kiki348/codex-micro-diy/hardware/gerber/STATUS.md

# 制板文件核对状态

2026-10-13 已核对当前工程、下载目录和旧工程归档。找到的 Gerber 压缩包属于早期 STM32 RevA 或其他上游参考项目，不能与 ESP32-S3 `.18` 固件配套。
当前可用源文件为上级目录的 2026-08-10 EPRO2 工程。可在嘉立创 EDA 中直接打开对应控制板和键轴板导出制板文件。
网页编辑器的控制板检查最终显示一项网表不一致，尚需核对。当前目录不提供冒充已核查版本的旧 Gerber，也不宣称制造包已经完成验收。
