kiki348/codex-micro-diy/THIRD_PARTY_NOTICES.md

# 来源、许可与归属

| 内容 | 来源 | 处理 |
|---|---|---|
| 原理图/PCB/原作者机构 | [wlk6655工程](https://oshwhub.com/wlk6655/project_arhgqemg) | 当前页面BSD-2-Clause；保留署名及完整许可正文 |
| 上游固件 | [wanglinkai326仓库](https://github.com/wanglinkai326/led-control-system-firmware) | 保留来源与文件版权头；MIT头为imliubo署名，不改变权利人 |
| 本地固件适配/教程/发布脚本 | 本仓库 | 新增贡献MIT；不把上游全体文件改标为本项目原创 |
| Arduino-ESP32/ESP-IDF启动文件 | Espressif | 按构建框架原许可分发，发行包附许可目录 |
| WorkAxis运行包 | 基于官方Input的修改版 | 闭源运行包，保留Electron/Chromium和依赖许可 |
| 实物照片 | 本DIY键盘实拍 | 真实产品照片；封面辅助图形为示意 |

原工程作者正文允许个人制作与分发改进，并列出固件源码链接；平台统一页脚有商业性使用限制。本项目不出售资料、不据此对第三方商标/商业权利另作授权。维护者于2026-10-13确认此前已取得本项目开发与公开再分发许可；该确认不替代原文件许可证，也不将缺失许可头补写成作者从未签署的声明。

固件仓库根目录没有完整LICENSE，部分文件有SPDX MIT。本仓库明确保留这一许可记录缺口，复用上游部分时同时查看原作者工程声明与各文件版权头；本地新增MIT许可不扩大第三方授权范围。

Codex、Input、Work Louder等名称用于说明兼容对象，归各自权利人所有。本DIY项目无官方合作或认证声明。
