kiki348/codex-micro-diy/docs/use-cases.md

# Codex Micro 玩法资料与采用记录

核查日期：2026-10-13。优先使用官方原始演示和作者自己的项目说明。

| 来源 | 可核查的玩法 | 视频采用 | 与本机的关系 |
|---|---|---|---|
| [OpenAI 官方演示](https://www.youtube.com/watch?v=m8uUUUsMD3Y) 00:24、01:28、01:49 | 语音提出猜词游戏，排队追加连胜效果，展示游戏结果 | 自绘 COLD→CORD→WORD→WARD→WARM 游戏与追加需求动画 | 原版玩法重绘，不是本机联动录屏 |
| 同一演示 00:45、01:01、01:16 | 旋钮调节思考；按键选择任务；通知和授权 | 旋钮与档位同步、按键与任务同步、确认提示 | 原版玩法动画 |
| 同一演示 01:44、01:59 | 等待时盘摇杆、可配置操作包括触发桌宠 | 摇杆摆动与自绘小桌宠 | 原版提到的用途；桌宠美术为本项目自绘 |
| [OpenAI / Work Louder 产品页](https://openai.com/supply/co-lab/work-louder/) | Agent 状态灯、工作流摇杆、专用操作键、思考旋钮 | 对照演示核查，不把灯光写成 AI 本体 | 原版产品规格不能套给 DIY：原版 13 开关，本机 12 按键 |
| [作者的周末 DIY](https://github.com/Nishkalkashyap/codex-micro-device) | ESP32-S3、手工接线、快捷键、3D 打印；明确未实现原版状态反馈 | 作为复刻路线的研究参考，不复制其结构文件和价格 | 是另一位作者的项目，不能当作我们的实测 |
| [OpenMicro 作者项目](https://github.com/stephenleo/OpenMicro) | 将类似操作映射到游戏手柄；声明不同工具的功能差异 | 用于“AI 手柄”创意判断；没有在片中宣称本机兼容其软件 | 外部工具，与本机不同 |
| [Codex Stream Deck 作者项目](https://github.com/dazer1234/codex-stream-deck) | Windows 上用 Stream Deck 控制 Codex 的非官方桥接 | 说明社区兴趣点是操作体验；不拼接到本机成果 | 外部项目 |

官方英文字幕通过浏览器提供的转写导出功能读取。具体观察：00:29 要求 One Letter Off，逐次改一个字母将 cold 变为 warm；00:52 旋钮控制 reasoning；01:05 固定任务映射到键；01:21 授权请求；01:36 要求更明显的胜利状态和连胜计数；01:44 摇杆可解压；01:59 自定义操作可触发 pet。

## 成片表达约束

5–39 秒持续显示“原版玩法重绘 · 非本机联动实录”。39 秒之后是真实 DIY 照片与制作路线。Windows 配置写入与回读已有核验，但不能据此宣称完整 Codex 联动已实测。当前板的 Gerber 导出仍待完善，不在片中称“Gerber 已全部可用”。不使用其他作者视频画面，不搬运原声或他们的工程。用户提供的配乐用于当前视频，原音频不进入公开仓库。
