kiki348/codex-micro-diy/docs/02-procurement.md

# 采购、价格与店铺

电子元件以 `hardware/bom/control-board.csv` 与 `key-board.csv` 为准：它们从实际 PCB 放置元件提取，排除了原理图电源符号。空白 MPN 是需要核对的项目，不代表随意替代。

| 物品 | 来源链接/规格 | 价格口径 |
|---|---|---|
| 主控 | ESP32-S3-WROOM-1U-N16R8，带天线接口 | 当前版本实付记录未完整恢复 |
| 半高轴 | [上游高特半高轴](https://item.taobao.com/item.htm?id=962160116626) | 上游推荐，非本项目已确认实付 |
| 旋钮编码器 | [上游 EC11](https://item.taobao.com/item.htm?id=532612286066) | 核对实际柄长；上游“15cm”有单位疑点，不能照抄采购 |
| 摇杆 | [PSP 平面 10k 无下压](https://detail.tmall.com/item.htm?id=521302135190&skuId=5927611536413) | 上游推荐，双轴电位器 |
| 排线 | 16pin FPC，原作者装配使用 10cm | 核对两端接点朝向、间距与座子锁扣 |
| 底板螺丝 | M2×8 平头/超薄平头自攻 | 按实际板厚和孔位试装 |
| 面板紧固 | 4 个 M3×3 隔离柱、4 个 M3×14 螺丝、4 个 M3 螺母 | 原作者装配规格 |
| 防滑脚垫 | 1mm 厚 | 原作者装配规格 |
| 电池与天线 | 必须按控制板接口、极性和下壳空间匹配 | 无确认型号时不补编购买链接 |

原附件推荐过“优信电子”等店铺，这是上游建议，不能当作本项目实际购买店铺。CSV 保留实际店铺/实付价格列，尚未找回的内容留空。

## 找回的历史支出

2026-08-03 的旧路线记录：PCB 5片实付3元，EC11 两个17元，KS33 Low Profile 2.0 17个25元，四件首版打印件历史券后货款/运费均0元，合计45元。**这些属于早期 STM32/首版路线，不是当前 ESP32-S3 成品总成本；KS33 也不等于当前高特半高轴。**

同记录中的元件103元、焊接150元是报价，非确认实付。当前项目总价不使用上述数字拼算。每条缺失价格可按公开 BOM 联系商家报价，记录日期、数量、运费与是否代焊。
