kiki348/codex-micro-diy/assets/keyboard-rgb.jpg

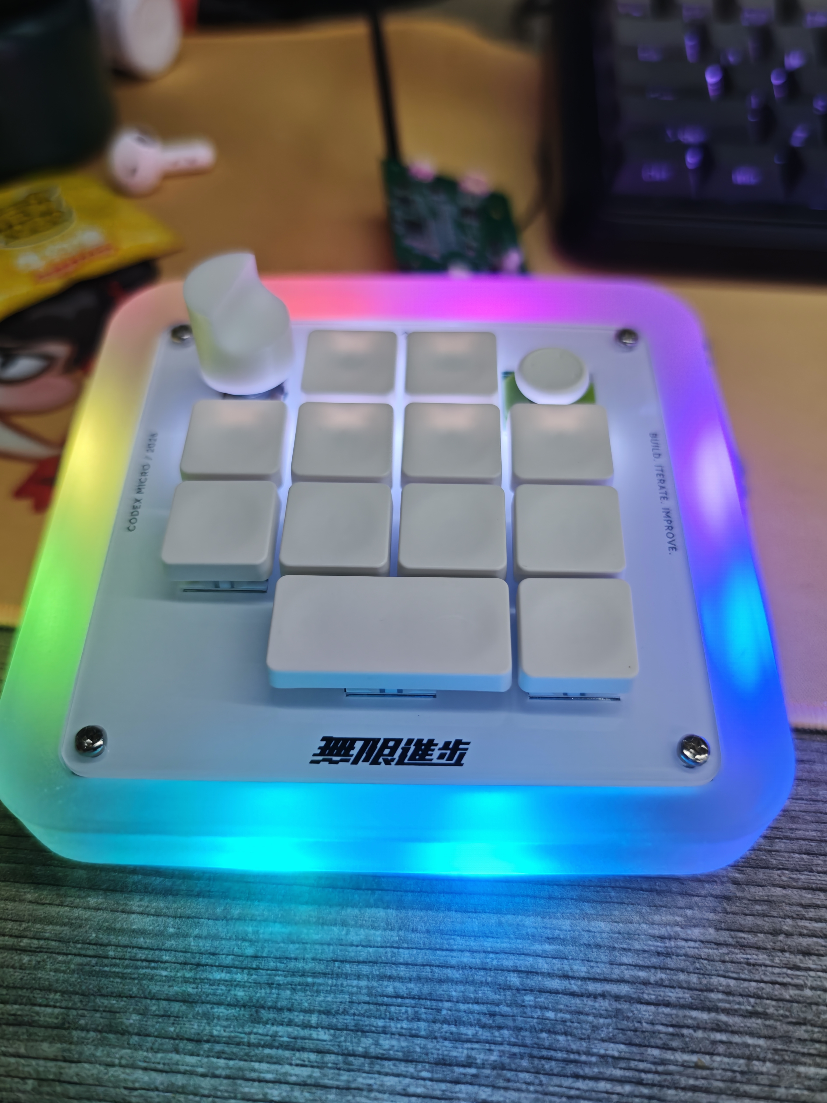
assets/keyboard-rgb.jpg
