kiki348/codex-micro-diy/hardware/bom/control-board.csv

位号 | 数量 | MPN | 制造商 | 值 | 封装 | 商城编号 | 贴装面 | X_mm | Y_mm | 角度 | 实际店铺 | 实际支付元 | 来源 | 核对状态
C1 | 1 | CL10A475KO8NNNC | SAMSUNG(三星) | 4.7uF | C0603 | C19666 | Top | 54.5 | -10.5 | 90 |  |  | 2026-08-10 PCB e43935b56b465ac6 | 源 PCB MPN 已提取；未验证库存/替代料
C17 | 1 | CL10A106KP8NNNC | SAMSUNG(三星) | 10uF | C0603 | C19702 | Top | 67.7 | -34.4 | 0 |  |  | 2026-08-10 PCB e43935b56b465ac6 | 源 PCB MPN 已提取；未验证库存/替代料
C18 | 1 | CL10B104KB8NNNC | SAMSUNG(三星) | 100nF | C0603 | C1591 | Top | 67.7 | -30.1 | 0 |  |  | 2026-08-10 PCB e43935b56b465ac6 | 源 PCB MPN 已提取；未验证库存/替代料
C19 | 1 | CL10B104KB8NNNC | SAMSUNG(三星) | 100nF | C0603 | C1591 | Top | 69.5 | -40.9 | 90 |  |  | 2026-08-10 PCB e43935b56b465ac6 | 源 PCB MPN 已提取；未验证库存/替代料
C2 | 1 | CL10A226MP8NUNE | SAMSUNG(三星) | 22uF | C0603 | C86295 | Top | 66.1 | -14.2 | 180 |  |  | 2026-08-10 PCB e43935b56b465ac6 | 源 PCB MPN 已提取；未验证库存/替代料
C20 | 1 | CL10A106KP8NNNC | SAMSUNG(三星) | 10uF | C0603 | C19702 | Top | 66.9 | -40.9 | 90 |  |  | 2026-08-10 PCB e43935b56b465ac6 | 源 PCB MPN 已提取；未验证库存/替代料
C21 | 1 | CL10A226MP8NUNE | SAMSUNG(三星) | 22uF | C0603 | C86295 | Top | 20.2999 | -20.0 | 0 |  |  | 2026-08-10 PCB e43935b56b465ac6 | 源 PCB MPN 已提取；未验证库存/替代料
C22 | 1 | CL10B104KB8NNNC | SAMSUNG(三星) | 100nF | C0603 | C1591 | Top | 20.2077 | -22.3027 | 0 |  |  | 2026-08-10 PCB e43935b56b465ac6 | 源 PCB MPN 已提取；未验证库存/替代料
C25 | 1 | CL10B104KB8NNNC | SAMSUNG(三星) | 100nF | C0603 | C1591 | Top | 48.5077 | -24.0177 | 180 |  |  | 2026-08-10 PCB e43935b56b465ac6 | 源 PCB MPN 已提取；未验证库存/替代料
C3 | 1 | CL10B104KB8NNNC | SAMSUNG(三星) | 100nF | C0603 | C1591 | Top | 66.1 | -16.5 | 180 |  |  | 2026-08-10 PCB e43935b56b465ac6 | 源 PCB MPN 已提取；未验证库存/替代料
C4 | 1 | CL10A226MP8NUNE | SAMSUNG(三星) | 22uF | C0603 | C86295 | Top | 65.6 | -25.0 | -90 |  |  | 2026-08-10 PCB e43935b56b465ac6 | 源 PCB MPN 已提取；未验证库存/替代料
C5 | 1 | CL10B104KB8NNNC | SAMSUNG(三星) | 100nF | C0603 | C1591 | Top | 63.4 | -25.0 | -90 |  |  | 2026-08-10 PCB e43935b56b465ac6 | 源 PCB MPN 已提取；未验证库存/替代料
C6 | 1 | CL10B104KB8NNNC | SAMSUNG(三星) | 100nF | C0603 | C1591 | Top | 55.8 | -37.2 | 90 |  |  | 2026-08-10 PCB e43935b56b465ac6 | 源 PCB MPN 已提取；未验证库存/替代料
C7 | 1 | CC0603KRX7R9BB102 | YAGEO(国巨) | 1nF | C0603 | C100040 | Top | 18.6 | -34.2 | 90 |  |  | 2026-08-10 PCB e43935b56b465ac6 | 源 PCB MPN 已提取；未验证库存/替代料
C8 | 1 | CGA0603X5R105K500JT | HRE(芯声) | 1uF | C0603 | C6119852 | Top | 26.9 | -40.7 | 0 |  |  | 2026-08-10 PCB e43935b56b465ac6 | 源 PCB MPN 已提取；未验证库存/替代料
D1 | 1 | SS34 | TWGMC(台湾迪嘉) |  | SMA_L4.3-W2.5-LS5.0-RD | C727060 | Top | 60.4 | -24.2 | 90 |  |  | 2026-08-10 PCB e43935b56b465ac6 | 源 PCB MPN 已提取；未验证库存/替代料
D3 | 1 | SS34 | TWGMC(台湾迪嘉) |  | SMA_L4.3-W2.5-LS5.0-RD | C727060 | Top | 71.8 | -28.0 | 90 |  |  | 2026-08-10 PCB e43935b56b465ac6 | 源 PCB MPN 已提取；未验证库存/替代料
FPC1 | 1 | FPC16-T1T1-2020-A | SHETIME(高钺达) |  | FPC-SMD_16P-P0.50_FPC16-T1T1-2020-A | C52740846 | Top | 35.3751 | -45.4161 | 0 |  |  | 2026-08-10 PCB e43935b56b465ac6 | 源 PCB MPN 已提取；未验证库存/替代料
H1 | 1 | 2.54-1x6P直针 | BOOMELE(博穆精密) |  | HDR-TH_6P-P2.54-V-M-1 | C37208 | Top | 54.2 | -31.8 | 0 |  |  | 2026-08-10 PCB e43935b56b465ac6 | 源 PCB MPN 已提取；未验证库存/替代料
J1 | 1 |  |  |  | BAT_2P |  | Top | 62.8 | -10.4 | 0 |  |  | 2026-08-10 PCB e43935b56b465ac6 | 需要核对 MPN
L2 | 1 | SMMS0420-4R7M | SXN(顺翔诺) | 4.7uH | IND-SMD_L4.8-W4.5 | C133193 | Top | 60.8 | -16.9 | -90 |  |  | 2026-08-10 PCB e43935b56b465ac6 | 源 PCB MPN 已提取；未验证库存/替代料
Q1 | 1 | AO3401A | UMW(友台半导体) |  | SOT-23_L2.9-W1.3-P1.90-LS2.4-BR | C347476 | Top | 68.4 | -26.9 | 90 |  |  | 2026-08-10 PCB e43935b56b465ac6 | 源 PCB MPN 已提取；未验证库存/替代料
R1 | 1 | FRC0603J202 TS | FOJAN(富捷) | 2kΩ | R0603 | C2907137 | Top | 54.5 | -14.3 | 90 |  |  | 2026-08-10 PCB e43935b56b465ac6 | 源 PCB MPN 已提取；未验证库存/替代料
R12 | 1 | 0603WAF5101T5E | UNI-ROYAL(厚声) | 5.1kΩ | R0603 | C23186 | Top | 48.1861 | -10.4502 | 90 |  |  | 2026-08-10 PCB e43935b56b465ac6 | 源 PCB MPN 已提取；未验证库存/替代料
R14 | 1 | FRC0603J103 TS | FOJAN(富捷) | 10kΩ | R0603 | C2930027 | Top | 70.6 | -23.0 | -90 |  |  | 2026-08-10 PCB e43935b56b465ac6 | 源 PCB MPN 已提取；未验证库存/替代料
R17 | 1 | FRC0603J103 TS | FOJAN(富捷) | 10kΩ | R0603 | C2930027 | Top | 24.1051 | -18.1 | 0 |  |  | 2026-08-10 PCB e43935b56b465ac6 | 源 PCB MPN 已提取；未验证库存/替代料
R2 | 1 | FRC0603J104 TS | FOJAN(富捷) | 100kΩ | R0603 | C2907088 | Top | 48.6 | -29.2 | 0 |  |  | 2026-08-10 PCB e43935b56b465ac6 | 源 PCB MPN 已提取；未验证库存/替代料
R20 | 1 | FRC0603J104 TS | FOJAN(富捷) | 100kΩ | R0603 | C2907088 | Top | 48.6 | -26.7 | 0 |  |  | 2026-08-10 PCB e43935b56b465ac6 | 源 PCB MPN 已提取；未验证库存/替代料
R3 | 1 | FRC0603J103 TS | FOJAN(富捷) | 10kΩ | R0603 | C2930027 | Top | 49.3 | -15.0 | 180 |  |  | 2026-08-10 PCB e43935b56b465ac6 | 源 PCB MPN 已提取；未验证库存/替代料
R4 | 1 | FRC0603J103 TS | FOJAN(富捷) | 10kΩ | R0603 | C2930027 | Top | 49.3 | -17.6 | 180 |  |  | 2026-08-10 PCB e43935b56b465ac6 | 源 PCB MPN 已提取；未验证库存/替代料
R5 | 1 | FRC0603J104 TS | FOJAN(富捷) | 100kΩ | R0603 | C2907088 | Top | 40.5 | -36.3 | 0 |  |  | 2026-08-10 PCB e43935b56b465ac6 | 源 PCB MPN 已提取；未验证库存/替代料
R6 | 1 | FRC0603F1502TS | FOJAN(富捷) | 15kΩ | R0603 | C2906995 | Top | 67.5 | -19.4 | -90 |  |  | 2026-08-10 PCB e43935b56b465ac6 | 源 PCB MPN 已提取；未验证库存/替代料
R7 | 1 | FRC0603F1001TS | FOJAN(富捷) | 1kΩ | R0603 | C2907002 | Top | 17.0 | -39.0 | 270 |  |  | 2026-08-10 PCB e43935b56b465ac6 | 源 PCB MPN 已提取；未验证库存/替代料
R8 | 1 | FRC0603F1103TS | FOJAN(富捷) | 110kΩ | R0603 | C2906984 | Top | 67.5 | -22.6 | -90 |  |  | 2026-08-10 PCB e43935b56b465ac6 | 源 PCB MPN 已提取；未验证库存/替代料
R9 | 1 | 0603WAF5101T5E | UNI-ROYAL(厚声) | 5.1kΩ | R0603 | C23186 | Top | 51.783 | -10.4852 | 90 |  |  | 2026-08-10 PCB e43935b56b465ac6 | 源 PCB MPN 已提取；未验证库存/替代料
U1 | 1 | MT3608B | 西安航天民芯 |  | SOT-23-6_L2.9-W1.6-P0.95-LS2.8-BR | C19189893 | Top | 64.6 | -20.2 | -90 |  |  | 2026-08-10 PCB e43935b56b465ac6 | 源 PCB MPN 已提取；未验证库存/替代料
U2 | 1 | TP4057 | TPOWER(天源) |  | SOT-23-6_L2.9-W1.6-P0.95-LS2.8-BL | C440390 | Top | 57.4584 | -10.5459 | 90 |  |  | 2026-08-10 PCB e43935b56b465ac6 | 源 PCB MPN 已提取；未验证库存/替代料
U3 | 1 | TLV76133DCYR | TI(德州仪器) |  | SOT-223-4_L6.5-W3.5-P2.30-LS7.0-TR | C7527500 | Top | 74.4 | -36.4 | 180 |  |  | 2026-08-10 PCB e43935b56b465ac6 | 源 PCB MPN 已提取；未验证库存/替代料
U4 | 1 | ESP32-S3-WROOM-1U-N16R8 | ESPRESSIF(乐鑫) | 2.4GHz | WIRELM-SMD_ESP32-S3-WROOM-1U | C3013946 | Top | 35.7 | -24.4 | 0 |  |  | 2026-08-10 PCB e43935b56b465ac6 | 源 PCB MPN 已提取；未验证库存/替代料
U5 | 1 | TPS22918DBVR | TI(德州仪器) |  | SOT-23-6_L2.9-W1.6-P0.95-LS2.8-BR | C131941 | Top | 21.3 | -38.8 | 0 |  |  | 2026-08-10 PCB e43935b56b465ac6 | 源 PCB MPN 已提取；未验证库存/替代料
U8 | 1 | SN74AHCT125DR | TI(德州仪器) |  | SOIC-14_L8.7-W3.9-P1.27-LS6.0-BL | C155176 | Top | 49.9 | -40.1 | -90 |  |  | 2026-08-10 PCB e43935b56b465ac6 | 源 PCB MPN 已提取；未验证库存/替代料
USB2 | 1 | TYPE-C16PIN | SHOU HAN(首韩) |  | USB-C-SMD_TYPE-C16PIN | C393939 | Top | 49.9641 | -3.5922 | 180 |  |  | 2026-08-10 PCB e43935b56b465ac6 | 源 PCB MPN 已提取；未验证库存/替代料
