kiki348/codex-micro-diy/hardware/bom/upstream-reference.csv

来源工作表 | bom模板
 |  |  |  | Bill of Materials | codex control
 |  |  |  | Project Title： | codex control
 |  |  |  | Variant:
 |  |  |  | Report Time： | 2026年7月29日 12:35:17
No. | Quantity | Comment | Designator | Footprint | Value | Manufacturer Part | Manufacturer | 链接
1 | 2 | 330 | R1, R2 | R0603 | 330 |  |  | 店内搜索页-深圳市优信电子科技有限公司-淘宝网
2 | 3 | 100kΩ | R2, R5, R20 | R0603 | 100kΩ | FRC0603J104 TS |  | 大部分物料我推荐使用优信电子，他们家确实质量不错
3 | 22 | 100nF | C2, C3, C4, C5, C6, C7, C8, C9, C10, C11, C12, C13, C14, C15, C16 | C0603 | 100nF |  | SHETIME(高钺达)
4 | 7 | 10kΩ | R7, R10, R11 | R0603 | 10kΩ | RT0603BRD0710KL | worldsemi
5 | 4 | 10kΩ 8pin排阻 | RN1, RN2, RN3, RN4 | RES-ARRAY-SMD_0603-8P-L3.2-W1.6-BL | 10kΩ | 4D03WGJ0103T5E
6 | 2 | 10uF | C17, C20 | C0603 | 10uF | CL10A106KP8NNNC | YAGEO(国巨)
7 | 1 | 110kΩ | R8 | R0603 | 110kΩ | FRC0603F1103TS | UNI-ROYAL(厚声)
8 | 1 | 15kΩ | R6 | R0603 | 15kΩ | FRC0603F1502TS | Kailh(凯华)
9 | 1 | 1kΩ | R7 | R0603 | 1kΩ | FRC0603F1001TS
10 | 1 | 1nF | C7 | C0603 | 1nF | CC0603KRX7R9BB102 | null
11 | 1 | 1uF | C8 | C0603 | 1uF | CGA0603X5R105K500JT
12 | 3 | 22uF | C2, C4, C21 | C0603 | 22uF | CL10A226MP8NUNE | Nexperia(安世)
13 | 1 | 2kΩ | R1 | R0603 | 2kΩ | FRC0603J202 TS | SAMSUNG(三星)
14 | 1 | 4.7uF | C1 | C0603 | 4.7uF | CL10A475KO8NNNC | SAMSUNG(三星)
15 | 1 | 4.7uH | L2 | IND-SMD_L4.8-W4.5 | 4.7uH | SMMS0420-4R7M | YAGEO(国巨)
16 | 1 | 470nF | C1 | C0603 | 470nF |  | HRE(芯声)
17 | 2 | 5.1kΩ | R9, R12 | R0603 | 5.1kΩ | 0603WAF5101T5E | SAMSUNG(三星)
18 | 2 | 74HC165D,653 | U15, U16 | SOIC-16_L9.9-W3.9-P1.27-LS6.0-BL |  | 74HC165D,653 | TWGMC(台湾迪嘉)
19 | 1 | AO3401A | Q1 | SOT-23_L2.9-W1.3-P1.90-LS2.4-BR |  | AO3401A | SXN(顺翔诺)
20 | 1 | EC11柄长15 | SW13 | SW-TH_EC11XXXXXXXX |  |  | UMW(友台半导体)
21 | 1 | ESP32-S3-WROOM-1U | U4 | WIRELM-SMD_ESP32-S3-WROOM-1U | 2.4GHz | ESP32-S3-WROOM-1U-N16R8 | FOJAN(富捷)
22 | 2 | FPC16-T1T1-2020-A | FPC1 | FPC-SMD_16P-P0.50_FPC16-T1T1-2020-A |  | FPC16-T1T1-2020-A | FOJAN(富捷)
23 | 1 | MT3608B | U1 | SOT-23-6_L2.9-W1.6-P0.95-LS2.8-BR |  | MT3608B | FOJAN(富捷)
24 | 1 | SN74AHCT125DR | U8 | SOIC-14_L8.7-W3.9-P1.27-LS6.0-BL |  | SN74AHCT125DR | FOJAN(富捷)
25 | 2 | SS34 | D1, D3 | SMA_L4.3-W2.5-LS5.0-RD |  | SS34 | FOJAN(富捷)
26 | 1 | TLV76133DCYR | U3 | SOT-223-4_L6.5-W3.5-P2.30-LS7.0-TR |  | TLV76133DCYR | UNI-ROYAL(厚声)
27 | 1 | TP4057 | U2 | SOT-23-6_L2.9-W1.6-P0.95-LS2.8-BL |  | TP4057 | 西安航天民芯
28 | 1 | TPS22918DBVR | U5 | SOT-23-6_L2.9-W1.6-P0.95-LS2.8-BR |  | TPS22918DBVR | TPOWER(天源)
29 | 1 | TYPE-C16PIN | USB2 | USB-C-SMD_TYPE-C16PIN |  | TYPE-C16PIN | TI(德州仪器)
30 | 8 | WS2812B-4020 | LED1, LED2, LED3, LED4, LED5, LED6, LED7, LED8 | LED-SMD_WS2812B-4020 |  | WS2812B-4020 | ESPRESSIF(乐鑫) | WS2812B 4020幻彩 侧面 发光LED 贴片4020RGB内置IC可控幻彩灯珠-淘宝网
31 | 6 | Yo-WS2812B-3528反贴雾状 | U1, U3, U4, U5, U6, U7 | LED-SMD_L3.2-W2.8-BR_DY-S352818 |  | Yo-WS2812B-3528反贴雾状 | TI(德州仪器) | 3528反贴6028幻彩WS2812B内置IC可编程RGB七彩LED灯珠键盘发光管-淘宝网
32 | 12 | 高特键盘轴座
33 | 12 | 高特半高轴 | SW1, SW2, SW3, SW4, SW5, SW6, SW7, SW8, SW9, SW10, SW11, SW12 | 机械键盘轴-五脚 |  | CPG151101S11-16 | TI(德州仪器) | 高特矮轴机械键盘超薄轴体短键程半高MX插拔轴 换翰林阅Free3轴体-淘宝网
34 | 1 | 平面摇杆无下压 | U2 | 平面摇杆无下压 |  |  | SHOU HAN(首韩) | PSP摇杆3D操纵杆电位器90度平推型7*7 14*14MM B10K-1 SKRHABE010-tmall.com天猫
34 | 1 | FPC16pin排线10CM
36 | 1 | 803450锂电池
配件
1 |  | M3x14螺丝
2 |  | M2x8扁平头自攻
3 |  | M3螺母
4 |  | CLK键帽6透明6白色
5 |  | 5xM3x3隔离柱
6 |  | 硅胶防滑垫
来源工作表 | Field汇总
Project Title | codex control
Borard Title | 键轴板已居中单面smt
Schematic Title | Schematic5_3
PCB Title | PCB1_3
Variant Name
Total Quantity | 56
Report Time | 12:35:17
Report Date | 2026年7月29日
Report Date&Time | 2026年7月29日 12:35:17
File Name | BOM_键轴板已居中单面smt_PCB1_3_2026-07-29
Filter Option | Add into BOM:no;
