kiki348/codex-micro-diy/hardware/mechanical/optional/keycap_gtmx_lowprofile_1u.step

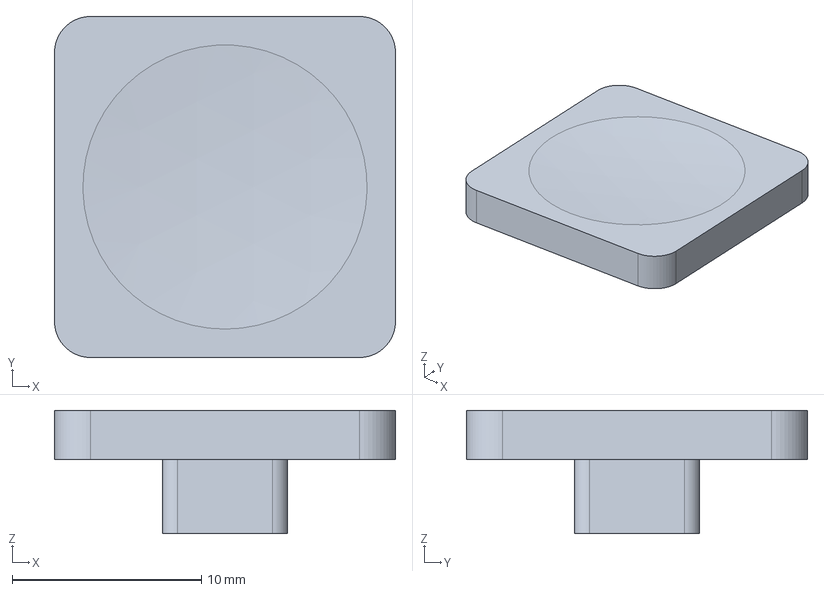
[picture p4: CAD file, 2026-10-13]
hardware/mechanical/optional/keycap_gtmx_lowprofile_1u.step
18.0 x 18.0 x 6.50 mm
