kiki348/codex-micro-diy/hardware/mechanical/outer-tolerance.step

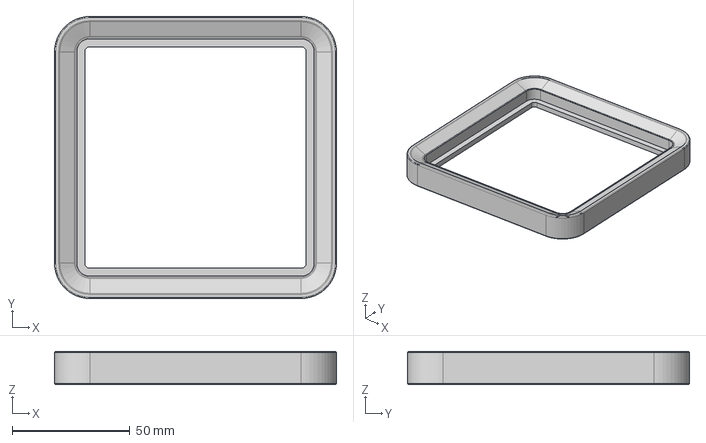
[picture p5: CAD file, 2026-10-13]
hardware/mechanical/outer-tolerance.step
120.0 x 120.0 x 14.2 mm
