kiki348/codex-micro-diy/hardware/mechanical/lower-housing.step

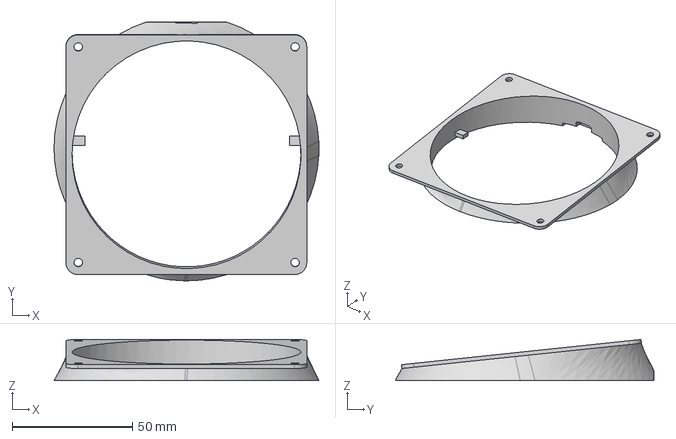
[picture p6: CAD file, 2026-10-13]
hardware/mechanical/lower-housing.step
110.0 x 107.4 x 17.0 mm
