kiki348/codex-micro-diy/hardware/mechanical/optional/knob_transparent_ready.step

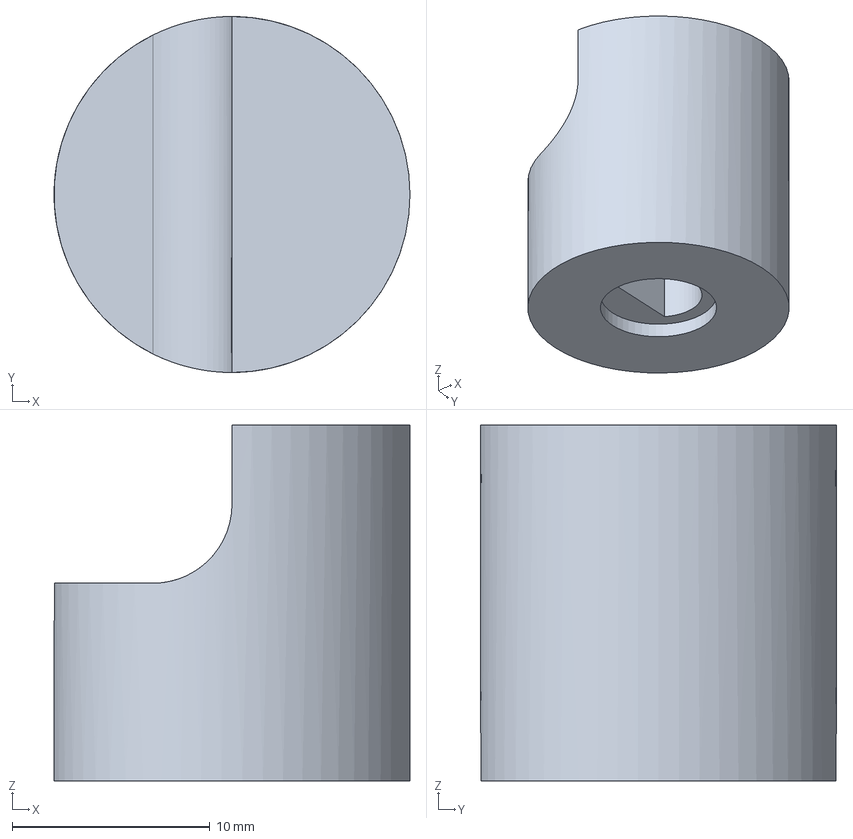
[picture p7: CAD file, 2026-10-13]
hardware/mechanical/optional/knob_transparent_ready.step
18.0 x 18.0 x 18.0 mm
