kiki348/codex-micro-diy/hardware/mechanical/optional/keycap_gtmx_lowprofile_2u_center_guide.step

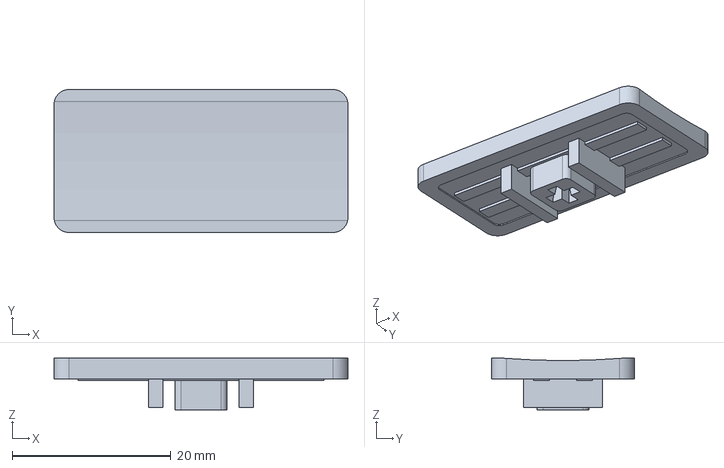
[picture p8: CAD file, 2026-10-13]
hardware/mechanical/optional/keycap_gtmx_lowprofile_2u_center_guide.step
37.0 x 18.0 x 6.50 mm
