kiki348/codex-micro-diy/hardware/mechanical/base-plate.step

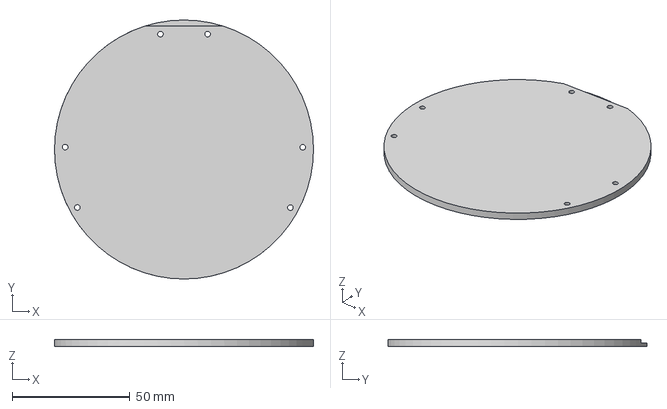
[picture p9: CAD file, 2026-10-13]
hardware/mechanical/base-plate.step
110.0 x 110.0 x 3.00 mm
