kiki348/codex-micro-diy/(list of files, cad)

Other CAD files:
hardware/mechanical/outer-shell.step
