kiki348/codex-micro-diy/docs/validation.md

# 验证范围与复现记录

核对日期：2026-10-13。以下区分静态检查与实体证据。

| 项目 | 当前证据 |
|---|---|
| `.18` 镜像身份 | 工作区镜像与交付镜像SHA256相同 |
| 镜像结构 | esptool识别ESP32-S3，启动程序/应用校验与内部Hash有效 |
| 分区 | NVS、OTA、app0/app1、SPIFFS边界已解析核对 |
| 固件源码构建 | 独立发布目录 PlatformIO 构建通过，ArduinoJson固定6.21.6 |
| 首烧工具 | 冻结EXE离线文件检查与内置esptool image_info通过；损坏文件/OTA单文件/错误地址拒绝 |
| 恢复工具依赖 | 在脱敏发行目录执行恢复模块 --check，依赖与资源哈希通过，未打开设备 |
| 实体固件版本 | 历史设备RPC读为0.5.0+work-axis.18 |
| 配置保存 | 一次真实UI修改，设备文件与诊断字段一致 |
| 12键 | 累计计数均非零，不等于本次逐键到软件动作全通过 |
| 首次烧录 | 空白板尚未实际验证；不会以构建/静态检查代替 |
| Windows发行包 | 本机已有启动/连接记录；第二台干净系统未验证 |
| Codex/Atelier兼容 | 完整实体操作到软件响应、无冲突尚未全部验证 |

复刻成功记录建议包含：板型、工程版本、固件SHA、从空白板烧录后的版本回读、断电重启、逐键/旋钮/摇杆响应、保存与重新连接结果。只上传脱敏结果，不上传个人设备全片备份。
