kiki348/codex-micro-diy/hardware/panel/panel-print-100mm.pdf

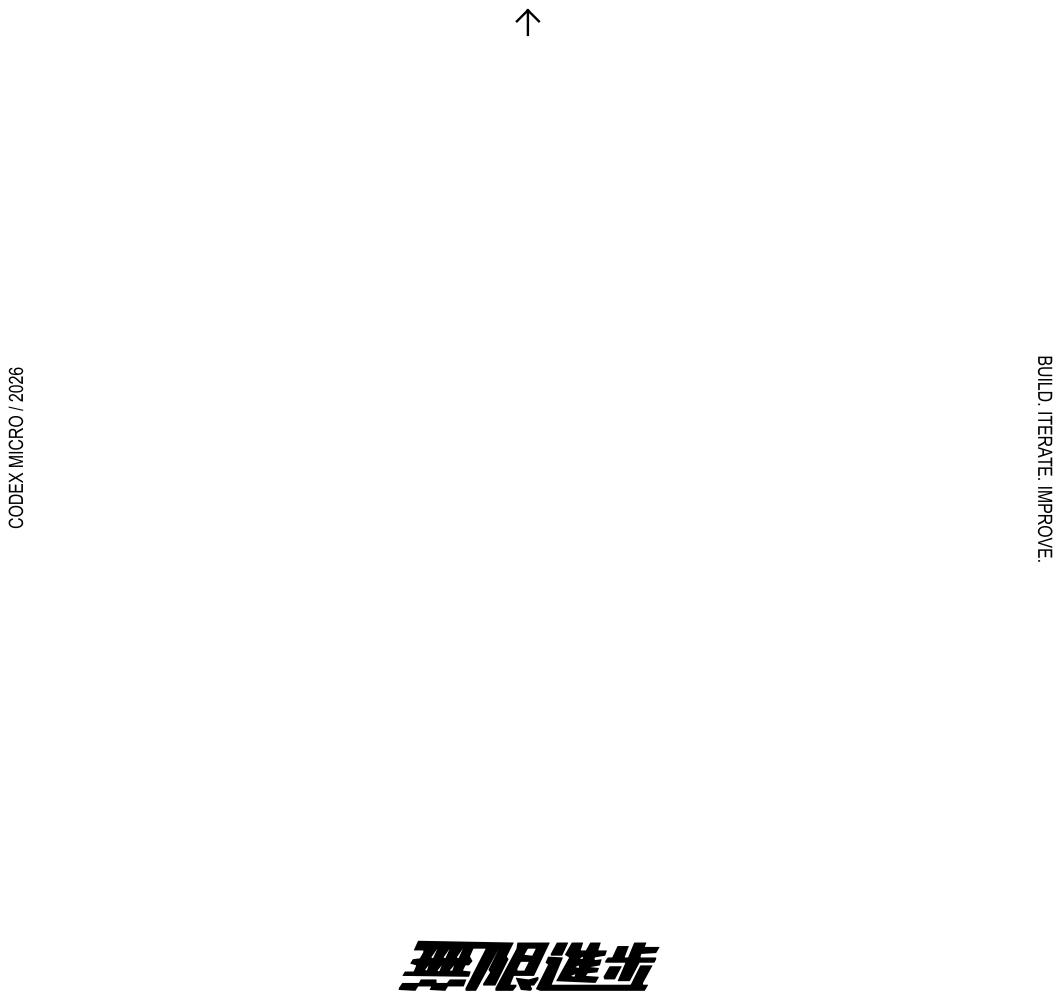
[picture p10: page 1]
